Reid-n0rc/open-bt-rig-interface/firmware/README.md

<!--
SPDX-FileCopyrightText: 2026 Reid Crowe, N0RC
SPDX-License-Identifier: PolyForm-Noncommercial-1.0.0
-->

# firmware

Device firmware. `app/` holds portable, host-tested logic (protocol, CAT passthrough, PTT safety, scheduling). `platform/<sdk>/` holds the SDK glue behind a small hardware-abstraction interface. `test/` holds host unit tests. Permissively licensed SDKs and dependencies only. License: PolyForm-Noncommercial-1.0.0 (non-commercial; see COMMERCIAL.md).
