Reid-n0rc/open-bt-rig-interface/THIRD_PARTY.md

<!--
SPDX-FileCopyrightText: 2026 Reid Crowe, N0RC
SPDX-License-Identifier: CC-BY-4.0
-->

# Third-party material and notices

This file is the **single ledger** of material from other projects that is
included in, adapted into, or bundled with this repository and its releases.
Any license that requires a copyright notice, license text or attribution is
satisfied from here.

The repository's own licensing is described in [`LICENSE`](LICENSE) and
[`REUSE.toml`](REUSE.toml). Third-party material **keeps its original license**
and is never relicensed under this project's licenses.

## When an entry is required

Add an entry, in the same PR, whenever you:

- copy or adapt source code, headers or build scripts (firmware, tools, CI);
- copy symbols, footprints or 3D models into `hardware/lib/` (including items
  taken from the KiCad libraries; see below);
- copy text, tables, figures or example circuits from datasheets, application
  notes, reference designs or other projects;
- add a firmware dependency whose code ends up in released binaries
  (SDK components, libraries), even when it isn't committed here;
- ship generated artifacts (fab outputs, STL/3MF, firmware images) that contain
  any of the above.

No entry is needed for facts learned from a source (a pinout, a voltage limit,
a protocol behavior) when nothing is copied. Cite such sources in the relevant
issue, ADR or doc instead.

## Rules

1. **Check the license in the source's actual LICENSE file** (and in file
   headers, which take precedence). Don't rely on a badge, an API summary or
   an earlier issue.
2. **Allowed to copy:** permissive licenses (MIT, BSD-2/3-Clause, ISC,
   Apache-2.0, Zlib, Unlicense/CC0) and CC-BY-4.0 / CC-BY-SA-4.0 for library
   or data files, with their obligations met.
3. **Never copy:** GPL, LGPL, AGPL, "no license", "all rights reserved", or
   terms limited to specific vendors' products (unless this project uses that
   vendor, and the restriction is recorded here). Such sources may be used for
   **facts only**. List them under [Facts only](#facts-only-never-copied).
4. **Keep notices intact:** leave original copyright/license headers in copied
   files, and add the license text to [`LICENSES/`](LICENSES/) under its SPDX
   ID.
5. **REUSE:** give third-party files their real SPDX copyright and license,
   either with file headers or with a path-specific `[[annotations]]` block in
   `REUSE.toml` that takes precedence over the project defaults.
   `uvx --from 'reuse[charset-normalizer]' reuse lint` must pass.
6. **Pin versions:** record the upstream commit or release tag, so the notice
   matches exactly what was used.
7. **Release notices:** every firmware release and every hardware release
   bundle must include a `THIRD_PARTY_NOTICES` file generated from the
   "Currently included" table (full license texts plus copyright lines).

## Entry format

| Field | Content |
|---|---|
| Name | Project or file name |
| Source | URL + pinned commit/tag |
| License | SPDX ID (verified from its LICENSE file) |
| Copyright | Exact copyright line(s) to reproduce |
| Used in | Paths in this repo, or "firmware binary" |
| Modifications | None / summary of changes |
| Obligations | For example "keep notice + license text in source and binary distributions" |
| Added in | PR / issue number |

## Currently included

The files in `LICENSES/` are license texts (taken from SPDX license-list-data)
and aren't third-party works that need an entry. Nothing below is committed to
this repository: the firmware build links it from the pinned SDK and the
pinned ESP Component Registry packages (`main/idf_component.yml`), and the
host tests fetch Unity at build time.

| Name | Source | License | Copyright | Used in | Modifications | Obligations | Added in |
|---|---|---|---|---|---|---|---|
| ESP-IDF | https://github.com/espressif/esp-idf, tag `v6.0.3` (commit `76f5dedd9950a3012fee8fb7d5586df21fc67802`) | Apache-2.0 ([LICENSE](docs/references/index.md#esp-idf-license)) | Copyright (C) 2015-2023 Espressif Systems (as stated in its [COPYRIGHT](docs/references/index.md#esp-idf-copyright) document; file headers take precedence) | Firmware binary (`firmware/platform/esp-idf`): drivers, FreeRTOS port, NVS, esp_timer, bootloader | None | Apache-2.0 text and notices in firmware releases | #14 |
| Components bundled with ESP-IDF v6.0.3 that the image links | As listed in ESP-IDF's [COPYRIGHT](docs/references/index.md#esp-idf-copyright) document | Apache-2.0 (Apache mynewt-nimble; the BLE controller, PHY and coexistence libraries, whose LICENSE files are Apache-2.0), Apache-2.0 OR GPL-2.0-or-later (Mbed TLS / TF-PSA-Crypto: **used under Apache-2.0**), MIT (FreeRTOS kernel, Xtensa headers), BSD (Picolibc/Newlib) | As stated in each component's LICENSE/COPYING file in the ESP-IDF tree | Firmware binary: NimBLE host (the BLE stack), BT controller, PHY and coexistence libraries, FreeRTOS, C library, TF-PSA-Crypto (NimBLE security) | None | Each license text and notice in the release's `THIRD_PARTY_NOTICES` (rule 7). The exact list comes from the linked components of the release build | #14 |
| esp-usb: `espressif/usb` 1.6.0, `usb_host_cdc_acm` 2.4.1, `usb_host_cp210x_vcp` 2.2.0, `usb_host_ftdi_vcp` 2.1.1, `usb_host_ch34x_vcp` 2.2.1 | https://github.com/espressif/esp-usb, from the ESP Component Registry, pinned exactly in `firmware/platform/esp-idf/main/idf_component.yml` (commits `630f1c4e`, `eb0f0216`, `ebfa6f84`, `cb8e2bd4`, `1a7c5aa5`, as each package's `idf_component.yml` records) | Apache-2.0 (each package's LICENSE and file headers; [LICENSE](docs/references/index.md#esp-usb-license)) | Copyright 2015-2026 Espressif Systems (Shanghai) CO LTD (the files' SPDX-FileCopyrightText headers; the years vary per file) | Firmware binary (`firmware/platform/esp-idf`): USB Host Library with hubs, and the CDC-ACM, CP210x, FTDI and CH34x serial drivers for the radio USB port | None (the FTDI RTS/DTR request is sent by this project's code instead of the driver's, see `main/radio_usb.c`) | Apache-2.0 text and notices in firmware releases | #43 |
| Unity | https://github.com/ThrowTheSwitch/Unity, tag `v2.7.0` (commit `b6763fbd9cedfacaa89e2ad9fd00d615a234e355`) | MIT ([LICENSE.txt](docs/references/index.md#unity-license)) | Copyright (c) 2007-26 Mike Karlesky, Mark VanderVoord, & Greg Williams | Host test build only (`firmware/test`, fetched by CMake); never in a firmware image | None | Keep notice + MIT text if it is ever redistributed | #14 |

## Known candidates (not yet included)

Sources already identified for upcoming work. Each license below was read from
the project's LICENSE file on 2026-09-24. **Re-check it when you actually pull
the material in**, and move the row to "Currently included".

| Name | Source | License | Copyright (from LICENSE) | Likely use | Obligations if used |
|---|---|---|---|---|---|
| ft8_lib | https://github.com/kgoba/ft8_lib | MIT | Copyright (c) 2018 Kārlis Goba | Optional on-device FT8/FT4 tone synthesis (#17) | Keep notice + MIT text in source and binaries |
| ESP32_ft8_lib | https://github.com/guido57/ESP32_ft8_lib | MIT | Copyright (c) 2018 Kārlis Goba (as stated in its LICENSE) | Reference/port of ft8_lib to ESP32 (#17) | Same as ft8_lib; also credit the port's author if any of its code is used |
| ESP32_BleSerial | https://github.com/avinabmalla/ESP32_BleSerial | MIT | Copyright (c) 2022 Avinab Malla | BLE-to-UART bridge reference (#15) | Keep notice + MIT text |
| esp32-ble-uart-mx | https://github.com/olegv142/esp32-ble-uart-mx | Unlicense | Public domain dedication | BLE-to-UART reference (#15) | None required; credit as a courtesy |
| ESP-ADF | https://github.com/espressif/esp-adf | "ESPRESSIF MIT License" (not SPDX MIT) | Copyright (c) 2018 Espressif Systems (Shanghai) | Audio framework, only if an Espressif module is selected | The grant covers **use on Espressif products only**; record that restriction here if it's used |
| KiCad libraries | https://gitlab.com/kicad/libraries | CC-BY-SA-4.0 + design exception | KiCad library contributors | Symbols/footprints/3D models | See the KiCad section below |

The other candidate firmware SDKs from the module decision (#7), such as
Infineon's or Microchip's, must be checked against rules 1–3 before selection.
Their license terms are part of the decision.

## KiCad library material

The KiCad libraries are CC-BY-SA-4.0 with an exception: designs that *use* the
library data (schematics, boards and generated fab files) are **not** bound by
it, and need no attribution
([license](https://gitlab.com/kicad/libraries/kicad-symbols/-/blob/master/LICENSE.md)).

However, **copying library items into `hardware/lib/`** redistributes part of
the library, so those copied files stay **CC-BY-SA-4.0**. Therefore:

- keep their attribution;
- give them a `REUSE.toml` annotation with `CC-BY-SA-4.0` and add
  `LICENSES/CC-BY-SA-4.0.txt`;
- list each copied item (or library file) under "Currently included".

Prefer referencing the stock libraries, and only copy an item when it has to
be modified or pinned. Vendor models and footprints from third-party
download sites often carry their own terms. Check them the same way, and
don't commit any that forbid redistribution.

## Facts only (never copied)

Sources consulted for facts, whose licenses don't allow copying into this
repository. Licenses were verified from each LICENSE file on 2026-09-24.

| Name | Source | License | Why listed |
|---|---|---|---|
| Digirig hardware | https://github.com/softcomplex/digirig | GPL-3.0 | Wired-interface reference; no schematics or layout copied |
| Mobilinkd TNC3 firmware | https://github.com/mobilinkd/tnc3-firmware | GPL-3.0 | BLE + audio interface reference |
| arduino-audio-tools | https://github.com/pschatzmann/arduino-audio-tools | GPL-3.0 | Microcontroller audio streaming reference |
| ESP-IDF examples `bluetooth/nimble/bleprph` and `custom_bootloader/bootloader_hooks` (v6.0.3) | [bleprph](docs/references/index.md#esp-idf-nimble-bleprph), [bootloader_hooks](docs/references/index.md#esp-idf-bootloader-hooks-example) | Apache-2.0 (bleprph's header; the hooks example has none and falls under ESP-IDF's Apache-2.0) | Consulted for the NimBLE start-up and bootloader-hook API sequence (#14); the firmware's code was written for this project, nothing copied. Permissive, listed for traceability |
| Linux kernel `drivers/usb/serial/ftdi_sio.h` | https://github.com/torvalds/linux/blob/f2c53ea949c5048f96b3dbb5a5ee7131ce4ff2de/drivers/usb/serial/ftdi_sio.h | GPL-2.0 | FTDI vendor request codes (modem control) checked against esp-usb for #9, and used for FTDI RTS/DTR in #43 (request 1, mask in the high byte); nothing copied |
| Linux kernel (`cdc-acm`, `snd-usb-audio`) | https://github.com/torvalds/linux (v6.16, `038d61fd`) | GPL-2.0 | Host driver behavior for USB CDC-ACM line state and USB Audio Class versions (#6) |
| BlueZ | https://github.com/bluez/bluez (5.87, `65d11ede`) | GPL-2.0 / LGPL-2.1 (`COPYING`, `COPYING.LIB`) | L2CAP LE CoC socket API and GATT D-Bus docs (#6) |
| Linux kernel USB network drivers (`drivers/net/usb/usbnet.c`, `cdc_ncm.c`, commit 038d61fd6422) | https://github.com/torvalds/linux | GPL-2.0 | CDC-NCM host behavior and interface naming (`usbN` / `ethN`) for the protocol's USB network transport (#13); nothing copied |

Add more rows as sources are consulted. Record unlicensed sources here too,
marked "no license".

## Standards and datasheets

Standards (for example ISO 16750-2, ISO 7637-2, CISPR 25), datasheets,
application notes and module integration guides are cited for their
requirements and values in the relevant docs and ADRs. Quoting or reproducing
figures, tables or reference circuits from them requires an entry here and
must comply with the publisher's terms. Many don't allow redistribution, so
summarize and cite instead.
