Reid-n0rc/open-bt-rig-interface/docs/research/power-radio-usbc.md

<!--
SPDX-FileCopyrightText: 2026 Reid Crowe, N0RC
SPDX-License-Identifier: CC-BY-4.0
-->

# Variant R power: radio accessory DC and USB-C (revision A)

Issue: [#11](https://github.com/Reid-n0rc/open-bt-rig-interface/issues/11).
Decision record: [ADR-0005](../decisions/ADR-0005-power-radio-usbc.md).

Scope: the variant R power input, from the radio's accessory DC pin and the
USB-C port to the 3.3 V rail. It covers protection, source selection,
regulation, the switching frequency, the power budget per mode, radio-on sense,
auto power up/down, parts and cost, and the EU EMC targets. Schematic capture
and layout are out of scope, and so is variant M
([#10](https://github.com/Reid-n0rc/open-bt-rig-interface/issues/10)).

Inputs:

- **Radio DC pins and current limits:** the per-radio table from #5
  ([PR #56](https://github.com/Reid-n0rc/open-bt-rig-interface/pull/56),
  `docs/research/radio-interfaces.md`), which cites the manufacturers' manuals
  page by page. This doc repeats only the figures it needs.
- **Module current:** [ESP32-S3-MINI-1 datasheet](../references/index.md#esp32s3-mini1-ds)
  Tables 6-5 to 6-7. BLE TX is capped at the FCC grant's 10.3 dBm
  ([`module-selection.md`](module-selection.md)), so the +9 dBm figure applies.
- **USB-C host power:** #6 ([PR #54](https://github.com/Reid-n0rc/open-bt-rig-interface/pull/54),
  `docs/research/host-compatibility.md` §2.4) and the
  [USB Type-C specification](../references/index.md#usb-typec-r20).
- **Codec rails:** ADR-0002 from #8 ([PR #55](https://github.com/Reid-n0rc/open-bt-rig-interface/pull/55))
  and the [TLV320AIC3104 datasheet](../references/index.md#ti-tlv320aic3104-ds).
- **Host links:** [ADR-0008](../decisions/ADR-0008-host-links-esp32-s3.md)
  (accepted). The issue predates it and has no ADR-0008 scope update, so this
  doc applies it: wired USB-C mode with the on-board hub, and isolation of the
  AUDIO and SERIAL jacks whenever the USB-C data link is used.
- **Variant M:** #10 ([PR #57](https://github.com/Reid-n0rc/open-bt-rig-interface/pull/57),
  ADR-0004) owns the **shared regulator core and the 2.304 MHz clock**. This
  doc uses them and specifies only what is particular to variant R.

Conventions: **(verify)** marks a fact or estimate that a bench test or a
later issue must confirm. `unknown` means no primary source was found.

## Maintainer decisions (2026-09-24)

1. **Power flows in only.** The device takes power from the radio's DC
   accessory pin or USB-C (and, on variant M, 12 V). **It never supplies
   power on any port, with one deliberate exception:** the SERIAL jack's
   ring-2 3.3 V output (about 20 mA, current-limited, off by default). It
   powers circuits inside a cable and never the radio (maintainer decision
   2026-09-25, recorded in ADR-0003, PR #61). Otherwise it doesn't source VBUS to the radio's USB port in
   either host mode, and it is a sink only on USB-C, in wired mode too.
   Hardware blocks current from the device into the radio's VBUS. That circuit,
   and the matching edits to `constraints.md` and `requirements.md`, belong to
   #9 (ADR-0003). Issue item 5 (a VBUS supply to the radio) and the IC-705
   battery-charging case therefore **no longer apply**. The K4 connects only
   through its USB-B port; its rear USB-A ports are not used for power or data.
2. **Optimize for spurious emissions and cost, and share the regulator core
   with variant M:** one **TI LMR43620MC3RPERQ1** buck (MODE/SYNC, no spread
   spectrum, fixed 3.3 V), synchronized in forced PWM to 2.304 MHz, fed
   directly from the OR of the two inputs. There's no 5 V rail. The input
   protection is sized for a station, not a car. Use the cheapest parts that
   meet −20 to +60 °C and the electrical need; AEC-Q isn't required.
3. **EU requirements (#59):** every part must be RoHS-compliant. EU EMC
   (EN 55032 Class B, EN 301 489-1 immunity) is a design target alongside FCC
   Part 15B (§10).

## Summary

- **Radio DC input (11–15 V nominal, 9–17.5 V accepted):** **0.25 A fast
  fuse** (the current limit: it opens within 5 s at 0.5 A, the K3's pin limit)
  → **B5819W Schottky** (reverse polarity, no back-feed into the radio) →
  **SMBJ15A TVS** → the power mux.
- **USB-C:** 5 V sink, 5.1 kΩ Rd on CC1 and CC2, no USB PD. The firmware reads
  CC to learn the host's current advertisement. Every mode fits the **500 mA**
  Default current.
- **Source selection:** one **TI TPS2121** priority power mux, directly on both
  inputs. Radio DC has priority when it is above 9 V; USB-C is the fallback.
  It controls inrush (soft start), cuts off each input on overvoltage
  (17.5 V and 5.8 V) and blocks back-feed into both sources.
- **Regulation:** the mux feeds one **LMR43620MC3RPERQ1** (3.3 V, 2 A),
  synchronized to the shared **2.304 MHz** clock (ADR-0004: an 18.432 MHz
  oscillator divided by 8 in three flip-flops). No harmonic from 160 m to 10 m lands in an
  amateur band (worst margin 85 kHz). The duty cycle stays inside the part's
  limits from 4.4 V to 17.5 V in. The same 2.304 MHz clock feeds the codec,
  whose PLL makes 48 kHz from it (ADR-0002, PR #55). The
  codec gets an **LP5907-3.0** LDO (analog) and a **TPS7A2018** (core, fed
  from the 3.0 V output), as ADR-0002 specifies.
- **Power budget:** 0.5–1.4 W average, 1.6 W peak. **Wired mode draws about
  292 mA from USB-C at 4.75 V (315 mA at 4.4 V)**, about 185 mA under the
  500 mA Default.
- **Radios that can power variant R:** IC-7300, TS-590SG, K3, K3S and K4
  (documented limits, switched outputs). The Yaesu +13 V pins and the TS-590S
  wait for a bench measurement. The IC-705, KX2, KX3, X6100 and
  FT-817ND/FT-818 use USB-C.
- **Radio-on sense:** the switched DC pin; otherwise the radio's USB attach,
  the SERIAL-jack idle level, or a CAT reply. Radio-powered: the device follows
  the radio. Otherwise, **with no USB host attached**, it powers down **30 s
  after radio-on sense goes off** (configurable, 0 = never). It stays awake
  while a USB host is connected (maintainer decisions, 2026-09-25).
- **Power-section BOM:** about **$6.4 at quantity 100** (§9.2), with the buck
  at TI.com's $2.494 (LCSC charges $3.99 and holds only 10).

## 1. Radio DC input

### 1.1 What the radios supply

From #5 (manual page citations there):

| Radio | Pin | Voltage | Documented limit | Switched with radio |
|---|---|---|---|---|
| IC-7300 | ACC pin 8 | 13.8 V | 1 A | Yes |
| TS-590SG | EXT.AT pin 6 "14S" | 13.8 V | 4 A | Yes |
| TS-590S | EXT.AT pin 6 "14S" | 13.8 V | `unknown` | Yes |
| K3 | 12 VDC OUT (RCA) | 13 V no load, **12 V at max load** | **0.5 A** | Yes |
| K3S | 12 VDC OUT (RCA) | 13 V no load, 12 V at max load | 1.0 A | Yes |
| K4 | 12 VDC OUT | 12 V | 1.5 A (self-resetting fuse) | Yes |
| FT-891, FT-991A | TUN/LIN "+13V OUT" | 13 V | `unknown` | `unknown` |
| FT-710 | TUNER/LINEAR pin 1 "+13V" | 13 V | `unknown` | Yes |
| FT-817ND / FT-818 | ACC "+13.8V" | Not stated; radio runs on 8–16 V or battery | `unknown` | `unknown` |

Design limits taken from this table:

- **Current limit below 0.5 A** (the K3, the lowest documented limit).
- **Voltage:** 12 V under load on the Elecraft pins; Icom's supply range of
  13.8 V ± 15 % (up to 15.9 V) passes straight through to the pin.
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
