Reid-n0rc/open-bt-rig-interface/docs/research/audio-codec.md

<!--
SPDX-FileCopyrightText: 2026 Reid Crowe, N0RC
SPDX-License-Identifier: CC-BY-4.0
-->

# Audio codec and isolation transformers

Issue: [#8](https://github.com/Reid-n0rc/open-bt-rig-interface/issues/8).
Researched 2026-09-24. Decision: [ADR-0002](../decisions/ADR-0002-audio-codec.md).

This study covers the **analog radio audio path**: the codec, the AUDIO-jack
isolation transformers, RF hardening at the jack, and the level plan. Radios
with a built-in USB sound card use the USB path instead
([ADR-0008](../decisions/ADR-0008-host-links-esp32-s3.md),
[constraints §8](../requirements/constraints.md#8-audio)).

**Scope adapted to ADR-0008.** The issue text predates ADR-0008 and asks for
compatibility with an HFP audio path. There is no Bluetooth Classic and no HFP.
The codec connects to the **ESP32-S3 over I2S** and serves both host links:
the Bluetooth LE audio stream and the USB Audio Class sound card in wired mode.
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
