Reid-n0rc/open-bt-rig-interface/docs/developer-guide.md

# Developer guide

This is the practical *how-to* for working on open-bt-rig-interface, for people and
AI agents alike. The **rules** live in [`AGENTS.md`](../AGENTS.md) and the short
version in [`CONTRIBUTING.md`](../CONTRIBUTING.md). This guide links to both
rather than repeating them. If this guide and `AGENTS.md` disagree, `AGENTS.md`
wins; please open an issue so the guide gets fixed.

Before any design work, read
[`docs/requirements/constraints.md`](requirements/constraints.md).

## Contents

1. [Prerequisites and setup](#1-prerequisites-and-setup)
2. [Repo tour](#2-repo-tour)
3. [From issue to merged PR](#3-from-issue-to-merged-pr)
4. [Local checks](#4-local-checks)
5. [Recipes by type of work](#5-recipes-by-type-of-work)
6. [Releases and tags](#6-releases-and-tags)
7. [Troubleshooting](#7-troubleshooting)

---

## 1. Prerequisites and setup

| Tool | Why | Notes |
|---|---|---|
| git ≥ 2.34 | Version control, SSH commit signing | Signed commits are preferred, not required (see below) |
| [GitHub CLI `gh`](https://cli.github.com/) | Issues, PRs, checks | `gh auth login` |
| [KiCad](https://www.kicad.org/download/) **≥ 10.0.6** | Schematic/PCB | Must match [`KICAD_VERSION`](../KICAD_VERSION) |
| `kicad-cli` | ERC/DRC and exports from the shell | Ships with KiCad (paths below) |
| [`uv`](https://docs.astral.sh/uv/) | Runs `reuse` without a global install | `uvx --from 'reuse[charset-normalizer]' reuse lint` |
| [Konnect](https://github.com/Reid-n0rc/Konnect) | KiCad MCP server that agents **must** use for KiCad changes | Load the `konnect` skill first (see [`AGENTS.md`](../AGENTS.md#hardware-kicad)) |
| Firmware SDK | Device firmware | **TBD**: chosen by the module decision (#7) and set up in #14 |

### `kicad-cli` location

| OS | Path |
|---|---|
| macOS | `/Applications/KiCad/KiCad.app/Contents/MacOS/kicad-cli` |
| Windows | `C:\Program Files\KiCad\10.0\bin\kicad-cli.exe` |
| Linux | `kicad-cli` on `PATH` (distribution or official PPA/Flatpak package) |

Check the version with `kicad-cli version`. It must be at least the
`KICAD_MIN_VERSION` in [`KICAD_VERSION`](../KICAD_VERSION). CI runs the pinned
`kicad/kicad:<KICAD_MIN_VERSION>` Docker image.

### Signed commits (preferred)

Signed commits (SSH or GPG) are preferred but not required. The branch ruleset
doesn't enforce signatures; PRs are still required for `main` and `dev`. SSH
signing is the simplest option:

```sh
git config --global gpg.format ssh
git config --global user.signingkey ~/.ssh/<your-key>.pub
git config --global commit.gpgsign true
# Let git verify your own signatures locally:
echo "$(git config user.email) $(cat ~/.ssh/<your-key>.pub)" >> ~/.ssh/allowed_signers
git config --global gpg.ssh.allowedSignersFile ~/.ssh/allowed_signers
```

Then add the same public key to GitHub as a **Signing key** (Settings → SSH and
GPG keys → New SSH key → Key type: *Signing Key*). GPG signing works too.

If you have signing set up, keep it on; don't pass `--no-gpg-sign` or
`-c commit.gpgsign=false`. If signing fails, fix the setup or mention it in the
PR rather than silently committing unsigned.

### Private or local tooling

Anything private, credentialed or specific to your machine goes in the untracked
`AGENTS.local.md` or `CLAUDE.local.md` at the repo root (both are gitignored).
Never commit credentials, and never name private tools in tracked files.

---

## 2. Repo tour

| Path | What's there |
|---|---|
| [`hardware/boards/`](../hardware/boards/) | KiCad projects, `hardware/boards/<board>/rev<X>/` |
| [`hardware/lib/`](../hardware/lib/) | Project-local symbols, footprints, 3D models |
| [`hardware/enclosure/`](../hardware/enclosure/) | 3D-printed enclosure CAD source |
| [`firmware/`](../firmware/) | `app/` portable core, `platform/<sdk>/` SDK glue, `test/` host tests |
| [`protocol/`](../protocol/) | Versioned host-device Bluetooth protocol spec and golden vectors |
| [`tools/`](../tools/) | Scripts and checks (KiCad version check, etc.) |
| [`docs/requirements/`](requirements/) | Constraints and requirements |
| [`docs/decisions/`](decisions/) | ADRs, one decision per file |
| [`docs/bringup/`](bringup/), [`docs/compliance/`](compliance/) | Bench bring-up notes, FCC/regulatory material |
| [`LICENSES/`](../LICENSES/), [`REUSE.toml`](../REUSE.toml) | License texts and the path-to-license mapping |

Every directory has a `README.md` explaining its purpose. Read it before adding files there.

**Licensing and governance:** this guide deliberately doesn't restate license
terms. Which license applies to which path, and any commercial-use or
governance terms, are defined in [`LICENSE`](../LICENSE),
[`REUSE.toml`](../REUSE.toml) and [`AGENTS.md`](../AGENTS.md#licensing-reuse),
plus [`COMMERCIAL.md`](../COMMERCIAL.md) and [`GOVERNANCE.md`](../GOVERNANCE.md).

---

## 3. From issue to merged PR

The full rules are in [AGENTS.md → Workflow](../AGENTS.md#workflow). Step by step:

1. **Pick or open an issue.** No change without one. Open issues use the
   templates in `.github/ISSUE_TEMPLATE/`. Issues labeled `human-task` need a
   person (hardware, accounts, a bench) and aren't for agents. The overall
   order of work is tracked in the roadmap issue (#22).
2. **Plan.** Write the plan in the issue (or in the PR description for small
   changes) before editing anything. Check the issue's *Verify first* items.
   If one turns out false, stop and comment on the issue.
3. **Branch from `dev`:**
   ```sh
   git fetch origin
   git switch -c <type>/<issue#>-<slug> origin/dev   # e.g. hw/9-cat-ptt-circuits
   ```
   Types: `hw`, `fw`, `proto`, `docs`, `ci`, `enc`, `research`. Git worktrees
   (`git worktree add ../<repo>-<slug> -b <branch> origin/dev`) keep parallel
   work separate.
4. **Commit** (signed if you can) and check before pushing:
   ```sh
   git log --format='%h %G? %s' origin/dev..HEAD   # G = good signature; N = unsigned (allowed)
   ```
5. **Run the local checks** in [section 4](#4-local-checks).
6. **Push and open the PR against `dev`:**
   ```sh
   git push -u origin <branch>
   gh pr create --base dev --title "…" --body "Closes #<issue>

   …"
   ```
   Fill in the PR template checklist.
7. **Merge.** Required checks must pass, and the ruleset requires a PR (signatures
   are preferred, not enforced). `dev` is the default branch, so `Closes #N` closes the issue when
   the PR merges. Merged branches are deleted automatically.
8. **Releases** go from `dev` to `main` through a release PR ([section 6](#6-releases-and-tags)).

---

## 4. Local checks

Run what applies to your change before pushing. CI runs the same checks:
`.github/workflows/checks.yml` (`REUSE lint`, `KiCad version consistency`,
`Silkscreen revision check`, `Protocol vectors`, `Firmware host tests`,
`Firmware target build (ESP-IDF)`) and `.github/workflows/kicad-checks.yml`
(`KiCad ERC/DRC gate`). They all always report, so they can be required status
checks.

**Licensing (every PR):**
```sh
uvx --from 'reuse[charset-normalizer]' reuse lint
```
Every new file needs SPDX headers or must be covered by
[`REUSE.toml`](../REUSE.toml). Which license a path gets is defined there and in
[AGENTS.md → Licensing](../AGENTS.md#licensing-reuse).

**KiCad version consistency (every PR):**
```sh
python3 tools/kicad_ci/check_kicad_version.py
```
Every `*.kicad_sch`, `*.kicad_pcb`, `*.kicad_sym`, `*.kicad_mod` and
`*.kicad_pro` must carry the format tokens in [`KICAD_VERSION`](../KICAD_VERSION):
`generator_version "10.0"` plus the file's format date (`version`), or
`meta.version` for projects. Footprints use the board format. Docs that quote a
minimum KiCad version ("KiCad ≥ X.Y.Z", "X.Y.Z or newer", `kicad/kicad:X.Y.Z`)
must quote `KICAD_MIN_VERSION`. If you saved files with a newer KiCad, bump
`KICAD_VERSION` (and the docs) in the same PR.

**ERC for schematic changes, DRC for PCB changes (both must pass to merge):**
```sh
kicad-cli sch erc --severity-all --exit-code-violations --format json \
  -o erc.json hardware/boards/<board>/rev<X>/<board>.kicad_sch

kicad-cli pcb drc --schematic-parity --severity-all --exit-code-violations \
  --format json -o drc.json hardware/boards/<board>/rev<X>/<board>.kicad_pcb
```
CI runs the same checks with the scripts in [`tools/kicad_ci/`](../tools/kicad_ci/),
inside the `kicad/kicad` image pinned by `KICAD_VERSION`. Their unit tests:
`python3 -m unittest discover -s tools/kicad_ci -p 'test_*.py'`.

A nonzero exit code means violations. Fix them, or document an intentional
exclusion in the KiCad project (not in CI), and say why in the PR. Agents can run
the same checks through Konnect's review tools.

**Silkscreen revision (hardware PRs):**
```sh
python3 tools/kicad_ci/check_silkscreen.py                    # every board
python3 tools/kicad_ci/check_silkscreen.py --tag hw-R-revA-v1.0  # as on a release tag
```
For each PCB in `hardware/boards/<board>/rev<X>/`: the title-block revision is
`<X>` and the date is set; front silkscreen text uses `${REVISION}` and
`${ISSUE_DATE}` and `${VARIANT}`; no silkscreen text hard-codes a revision; the
silkscreen shows the project name, "Designed by Reid Crowe, N0RC" and "CC
BY-NC-SA 4.0" (project text variables are resolved); and the board declares at
least one KiCad design variant with a tag-safe name. On an
`hw-<variant>-rev<X>-v<semver>` tag, a board in a `rev<X>` folder must declare
the design variant `<variant>` ([ADR-0006](decisions/ADR-0006-variants-and-board-strategy.md)).

**Firmware (host tests, every PR):**
```sh
cmake -S firmware/test -B build/fw-test
cmake --build build/fw-test
ctest --test-dir build/fw-test --output-on-failure
```
Builds [`firmware/app`](../firmware/app/) against a fake HAL with ASan and
UBSan, and runs the PTT, codec (every golden vector), configuration and
session tests. Needs CMake 3.16+, a C11 compiler, Python 3 and git
([`firmware/test/README.md`](../firmware/test/README.md)).

**Firmware (ESP32-S3 build):** install ESP-IDF v6.0.3 (or use the
`espressif/idf:v6.0.3` Docker image), then:
```sh
cd firmware/platform/esp-idf
idf.py set-target esp32s3   # once
idf.py build
idf.py -p <UART port> flash monitor
```
Flash through the ESP32-S3-DevKitM-1's USB-to-UART port; the pin map is in
[`BOARD.md`](../firmware/platform/esp-idf/BOARD.md). CI runs both as
`Firmware host tests` and `Firmware target build (ESP-IDF)`, and uploads the
images as an artifact.

**Protocol:** `python3 -m unittest discover -s tools/protocol -p 'test_*.py'`
and `python3 tools/protocol/make_vectors.py --check`.

---

## 5. Recipes by type of work

### Research or decision issue
1. Answer every question in the issue, with a source for each claim. Check the
   license of any design or code you look at and follow the third-party rules
   in [AGENTS.md → Licensing](../AGENTS.md#licensing-reuse): reuse only
   license-compatible material, keeping its notices and recording it in
   [`THIRD_PARTY.md`](../THIRD_PARTY.md). GPL, LGPL, AGPL and
   unlicensed sources are **facts only, never copied**.
2. Write findings to the path the issue names, and for decisions copy
   [`ADR-0000-template.md`](decisions/ADR-0000-template.md) to
   `docs/decisions/ADR-NNNN-<slug>.md`. Accepted ADRs are never edited; a later
   ADR supersedes them.
3. Update [`constraints.md`](requirements/constraints.md) when a *(verify)*
   value gets confirmed or corrected.
4. For parts: prefer **FCC-certified modules** (record the FCC ID and follow the
   integration guide), with at least two sources and an active lifecycle.
   Record alternates.

### Hardware change (KiCad)
1. **Agents: Konnect only.** Load the `konnect` skill, then the task skill
   (`kicad-schematic`, `kicad-pcb`, `kicad-library`, `kicad-review`,
   `kicad-manufacture`). Never hand-edit `.kicad_*` files.
2. Put new symbols, footprints and 3D models in `hardware/lib/…`, referenced
   through the project library tables with `${KIPRJMOD}`-relative paths. Never
   point at personal global libraries.
3. Keep the silkscreen template intact: project name, variant (`${VARIANT}`), `${REVISION}`,
   `${ISSUE_DATE}`, "Designed by Reid Crowe, N0RC", and the license mark
   required by [AGENTS.md](../AGENTS.md#hardware-kicad).
4. **Variants:** R and M are KiCad design variants of one board
   ([ADR-0006](decisions/ADR-0006-variants-and-board-strategy.md)). Change
   fitting or per-variant values in the schematic with that variant selected,
   then update the PCB from the schematic. Never copy the board to make a variant.
5. **New board revision:** copy `rev<X>` to `rev<X+1>`, update the title-block
   revision and date, and note it in [`CHANGELOG.md`](../CHANGELOG.md).
6. Run ERC and DRC ([section 4](#4-local-checks)). Don't commit fab outputs; CI
   builds them for releases.

### Firmware change
Portable logic goes in `firmware/app/` with host tests in `firmware/test/`, and
SDK glue in `firmware/platform/<sdk>/`. **PTT fail-safes are mandatory**, and
every new code path needs a test ([AGENTS.md → Firmware](../AGENTS.md#firmware)).
The SDK is ESP-IDF v6.0.3 on the ESP32-S3; build, test and flash commands are
in [section 4](#4-local-checks), and the layout in
[`firmware/README.md`](../firmware/README.md). Hardware access goes through
[`hal.h`](../firmware/app/include/hal.h), so new logic lands in `firmware/app`
with a host test and only the glue in `firmware/platform/esp-idf`. Changes to
the PTT controller need the maintainer's explicit approval in the PR.

### Protocol change
Edit the spec in [`protocol/`](../protocol/), bump the protocol version, and
regenerate or extend the golden byte vectors in the same PR. Host apps pin a
`proto-v…` release, so never change a released version in place. Details
arrive with #13.

### Enclosure change
Edit the parametric CAD source in `hardware/enclosure/<variant>/` (`R/` or `M/`; both fit the one board). STL/3MF files
are exported for releases, not committed (#19). Keep the antenna keep-out
area free of metal, and use ASA for the automotive variant.

### Human tasks
`human-task` issues (bench tests, printing, measurements, account actions) are
done by a person. Record the results in the issue and, where relevant, under
`docs/bringup/` or `docs/compliance/` through a normal PR.

---

## 6. Releases and tags

`main` receives releases only, through a `dev` → `main` PR. Tags:

| Artifact | Tag | Example |
|---|---|---|
| Hardware | `hw-<variant>-rev<X>-v<semver>` | `hw-R-revA-v1.0` |
| Firmware | `fw-v<semver>` | `fw-v0.1.0` |
| Protocol | `proto-v<semver>` | `proto-v1.0.0` |

A hardware tag must match the board's title-block revision and folder, and
name a design variant the board declares; each variant is tagged and released
separately (`hw-R-revA-v1.0`, `hw-M-revA-v1.0`), with outputs exported for that
variant only. Release
assets (Gerbers, drill, BOM, pick-and-place, PDFs, STL/3MF, firmware images)
are produced by CI and attached to the GitHub release.

---

## 7. Troubleshooting

| Symptom | Fix |
|---|---|
| Commit shows `N` or `E` in `git log --format='%G?'` | `N`: unsigned, which is allowed, though signing is preferred. `E`: git can't verify it locally because your key isn't in `allowed_signers`. See [section 1](#signed-commits-preferred). |
| Push to `dev` or `main` rejected | Expected. Push a feature branch and open a PR. |
| `uvx reuse lint` fails with an encoding / `charset_normalizer` error | Use `uvx --from 'reuse[charset-normalizer]' reuse lint`. |
| `reuse lint` reports an unused license | A license text in `LICENSES/` must be used by at least one file. Keep `REUSE.toml` and `LICENSES/` in step. |
| `kicad-cli: command not found` | Use the full path from [section 1](#kicad-cli-location), or add KiCad's `bin` to `PATH`. |
| KiCad version check fails after saving | You saved with a different KiCad. Use the version in `KICAD_VERSION`, or bump it in the same PR if the project is moving forward. |
| Issue closed but PR not merged, or the reverse | `Closes #N` only acts on merges into `dev` (the default branch). Check the PR base. |
