Reid-n0rc/open-bt-rig-interface/docs/bringup/README.md

<!--
SPDX-FileCopyrightText: 2026 Reid Crowe, N0RC
SPDX-License-Identifier: CC-BY-4.0
-->

# docs/bringup

Board bring-up procedures and results, per variant and revision.
