Reid-n0rc/open-bt-rig-interface/firmware/platform/esp-idf/main/status_led.h

/*
 * SPDX-FileCopyrightText: 2026 Reid Crowe, N0RC
 * SPDX-License-Identifier: PolyForm-Noncommercial-1.0.0
 */
#ifndef STATUS_LED_H
#define STATUS_LED_H

#include "esp_err.h"

esp_err_t status_led_init(void);

#endif /* STATUS_LED_H */
