Reid-n0rc/open-bt-rig-interface/(commit log)

2026-09-24 Bootstrap repo: agent docs, REUSE licensing, constraints, skeleton
    Add AGENTS.md (workflow, KiCad-via-Konnect, sourcing, silkscreen
    revision, licensing and tag rules) with CLAUDE.md as a pointer; REUSE
    layout with CERN-OHL-P-2.0 (hardware), MIT (firmware/tools/protocol)
    and CC-BY-4.0 (docs); the full design constraints; KICAD_VERSION;
    directory skeleton; ADR template; issue and PR templates.
    Closes #1
2026-09-24 Add revision A roadmap document with dependency graph and merge gates
    Mirrors tracking issue #22 (phases, issue numbers, human-task markers) and
    adds what the checklist can't carry: per-phase exit criteria, a Mermaid
    dependency graph built from each issue's Dependencies section, and the merge
    gates (ERC must pass for schematic changes, DRC for PCB changes, enforced by
    #3's required checks). No checkboxes, so status lives only in #22.
    Closes #23
2026-09-24 Add developer guide: setup, issue-to-PR walkthrough, local checks, recipes
    Practical how-to complementing AGENTS.md (rules) and CONTRIBUTING.md
    (short version): tool setup incl. KiCad >= 10.0.6 and SSH commit signing,
    repo tour, the issue -> branch -> signed PR -> dev flow, local REUSE/KiCad
    version/ERC/DRC checks, recipes per type of work, release tags and
    troubleshooting. License terms are referenced, not restated, so the
    upcoming licensing/governance changes don't need edits here.
    Closes #24
2026-09-24 Expand CONTRIBUTING.md into a full contributor guide
    Adds sections on ways to contribute (templates and labels), picking up work,
    hardware/firmware/protocol/docs expectations, safety and compliance,
    third-party material (THIRD_PARTY.md), AI-assisted contributions, conduct and
    where to find more. The existing intro, workflow list and licensing paragraph
    are left unchanged so the governance, developer-guide and license PRs merge
    cleanly.
    Closes #32
2026-09-24 Add THIRD_PARTY.md ledger for third-party material and notices
    Centralize where material from other projects (code, KiCad library items,
    copied text/figures, bundled firmware dependencies) is recorded with the
    notices its license requires. Point AGENTS.md, CONTRIBUTING.md, README,
    hardware/lib and the PR template at it.
    Closes #31
2026-09-24 CI: required ERC/DRC merge gate for schematic and PCB changes
    ERC runs on the root schematic of every project whose schematics change, and
    DRC (with schematic parity and zone refill) on every project whose PCB
    changes, inside the kicad/kicad image pinned by KICAD_VERSION. The always-run
    "KiCad ERC/DRC gate" job passes when there is nothing to check, so it can be
    a required status check. Selection and running live in tools/kicad_ci with
    unit tests that run in CI.
    Closes #26
2026-09-24 docs: core device shortlist for revision A (#42)
    Candidate key parts per block (radio module, codec, isolation, CAT/PTT,
    USB host, power R/M), with the radio-module candidates checked against
    the hard constraints and open items mapped to the block issues.
2026-09-24 docs: BLE-only design on ESP32-S3-MINI-1, radio connectors, reference library (#42)
    - ADR-0008 (proposed): Bluetooth LE-only host link on the ESP32-S3-MINI-1,
    with both analog radio audio and the radio's built-in USB sound card
    (USB host via espressif/esp-usb). Constraints and README updated.
    - Core device shortlist reworked around the ESP32-S3-MINI-1, with a
    modules-only BLE table (LCSC price/stock, 2026-09-24) and the record of
    why dual-mode Classic was dropped.
    - Radio connector spec: AUDIO and SERIAL 3.5 mm TRRS jacks with a
    cable-compatible pinout and firmware-selected serial modes, plus a
    USB-A host port.
    - Reference library: tracked manifest + generated index, tools/refs/r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
2026-09-24 docs: add wired USB-C host link and common radio side to ADR-0008 (#42)
    - ADR-0008 renamed and extended: Bluetooth LE and wired USB-C host links,
    identical radio-side support in both. In wired mode a 2-port hub and two
    USB switches let the computer reach the radio's own USB-serial chip and
    sound card, plus the device's own sound card and serial ports.
    - Isolation of the jacks is mandatory whenever USB-C data is used; optional
    ADuM4160 isolator on the radio USB port.
    - SERIAL-jack modes are RS-232 tolerant: TMUX6219 switches and a
    single-channel RS-232 transceiver (TRS3221E); RS-232 RTS/DTR outputs
    dropped because the cable-compatible jack has no contacts for them.
    - USB-C 500 mA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
2026-09-24 docs: PCB fabrication and passive-component constraints (#49)
    JLCPCB standard-process board and design rules, 2- vs 4-layer criteria,
    assembly (Basic parts, top side), resistor sizing/derating and MLCC
    selection with the 2x DC voltage rule and DC-bias check.
2026-09-24 docs: cite JLCPCB sources through the reference manifest (#49)
    Adds JLCPCB PCB capabilities, impedance stackup, and PCBA FAQ/price pages
    to docs/references/manifest.json and links pcb-fabrication.md to their
    index entries instead of external URLs.
2026-09-24 docs: requirements specification (#4)
    Numbered REQ-<area>-NNN requirements derived from constraints.md,
    ADR-0008, radio-connectors.md and pcb-fabrication.md, with verification
    methods, status, traceability to issues and a coverage checklist.
2026-09-24 ci: REUSE lint, KiCad version and silkscreen revision checks (#3)
    Add .github/workflows/checks.yml with three always-reporting jobs:
    REUSE lint, KiCad version consistency and Silkscreen revision check.
    - tools/kicad_ci/check_kicad_version.py: every *.kicad_sch/pcb/sym/mod/pro
    and every doc quoting the minimum KiCad version must match KICAD_VERSION.
    KICAD_VERSION gains KICAD_SYM_FORMAT (symbol libraries have their own
    format; footprints use the board format), confirmed with kicad-cli 10.0.6.
    - tools/kicad_ci/check_silkscreen.py: title-block revision vs rev<X> folder,
    ${REVISION}/${ISSUE_DATE} on the front silkscreen, no hard-coded revision,
    required markings, and hw-* tags matching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
2026-09-24 docs: confirm the ESP32-S3-MINI-1 module and add FCC integration notes (#7)
    - docs/research/module-selection.md: FCC grant review of 2AC7Z-ESPS3MINI1
    (single modular, DTS, BLE certified at 0.0107 W conducted, 20 cm mobile
    use), ISED 21098-ESPS3MINI1, SH6MDBT50Q for the fallback, Espressif's
    longevity commitment, dated LCSC price and stock, and risks. The findings
    support ADR-0008; Digi-Key and Mouser couldn't be read and are left blank.
    - docs/compliance/fcc.md: antenna placement and keep-out, enclosure
    clearance, BLE TX power cap, power/reset, USB and strapping-pin rules, host
    label text, user manual statements and a Part 15B SDoC checklist.
    - Reference manifest: grant, ISED cer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
2026-09-24 docs: five-OS host compatibility research for wired USB-C and BLE (#6)
    Adds docs/research/host-compatibility.md: driverless USB CDC-ACM and
    RTS/DTR, UAC1 vs UAC2, OS voice processing and USB-C port power per OS;
    Bluetooth LE PHY, DLE, MTU, connection intervals, L2CAP CoC vs GATT,
    throughput budget and background behavior; LE Audio status. Recommends
    UAC1 for #44 and NimBLE with L2CAP CoC plus a GATT fallback. Sources are
    added to the reference manifest; Linux and BlueZ are listed as facts only.
2026-09-24 docs: audio codec and isolation transformer study, ADR-0002 (#8)
    Compare six codec options and three isolation transformers against the
    constraints, adapted to ADR-0008 (I2S to the ESP32-S3, no HFP). Propose
    the TLV320AIC3104 (alternates TAC5112, TLV320AIC3204) and the Bourns
    SM-LP-5001, with the ESP32-S3 clocking plan, level plan and RF hardening.
    Add the cited datasheets to the reference manifest.
2026-09-24 docs: record -N8, 2-layer and ADR-0008 acceptance decisions (#7)
    Maintainer decisions: revision A uses ESP32-S3-MINI-1-N8, the Espressif
    FCC ID is trusted without further grant checks, 2 layers are acceptable
    for the module, and ADR-0008 is accepted.
2026-09-24 docs: per-radio power and interface table (#5)
    Add docs/research/radio-interfaces.md: DC outputs and current limits, USB
    port/chip/audio, CAT levels, PTT and audio levels for 13 HF/multiband
    radios plus generic interfaces, cited from manufacturer manuals, with
    cable mappings to the AUDIO and SERIAL jacks and a needs-measurement list.
    Add the manuals to the reference library (new `manual` kind) and link the
    findings from constraints.md and radio-connectors.md.
2026-09-24 docs: apply maintainer decisions to ADR-0002 (#8)
    Variant M uses the catalog TLV320AIC3104 (-Q1 noted only as an option).
    Variant R fits 0 ohm bypass resistors with the transformers DNP by
    default; flag the conflict with constraints section 6 in wired mode as an
    open question. Digi-Key and Mouser lookups are deferred by the maintainer,
    not a blocker.
2026-09-24 docs: variant M automotive power front end and ADR-0004 (#10)
    Confirm the ISO 16750-2:2023 and ISO 7637-2:2011 12 V test levels from
    reproducing app notes and the official ISO previews (jump start is now
    26 V). Design the variant M front end: LM74800-Q1 common-source
    load-dump cut-off with a 150 V FET and a TVS stack that absorbs no
    load-dump energy, CMC + pi filter sized against CISPR 25 class 5, two
    LMR43620-Q1 bucks synchronized at 2.304 MHz so no harmonic lands in a
    US HF amateur band, brownout detector forcing PTT off, hold-up and
    off-state drain calculations, dated LCSC/TI prices and stock.
    Update constraints.md 3.2/3.4 and pcb-fabrication.md 6.3 to match, and
    add the cited documents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
2026-09-24 proto: protocol spec 0.1.0, architecture, golden vectors, ADR-0007 (#13)
    - protocol/SPEC.md: one COBS-framed, CRC-16 message stream over BLE GATT,
    L2CAP CoC, TCP over a wired USB network interface (CDC-NCM) and the
    CDC-ACM control port; capability TLVs; CAT with credit flow control;
    PTT keepalive, max TX, RTS/DTR arming; BLE audio framing; clock sync;
    optional tone-sequence TX; capped BLE TX power; new GATT UUIDs.
    - protocol/vectors/: golden vectors for every message, framing and GATT.
    - tools/protocol/: MIT reference codec, vector generator and tests; new
    "Protocol vectors" CI job.
    - docs/architecture.md and ADR-0007 (proposed), including the ESP32-S3
    USB endpoint budget and per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
2026-09-24 docs: jump start is 26 V in REQ-PWR-014 (#10)
    ISO 16750-2:2023 raised the 12 V jump-start level from 24 V to 26 V.
2026-09-24 docs: MC buck variants, thermal limit, stock as data (#10)
    Apply maintainer decisions of 2026-09-24 on PR #57: use the
    LMR43620MC5RPERQ1 / MC3RPERQ1 (MODE/SYNC, no spread spectrum) with the
    MSC variants as alternates, and check the fixed 2.2 MHz pre-sync
    interval against the harmonic table. Record stock levels as data only,
    not as a risk. Add the 150 C TJ limit and typical-load thermal
    estimates, including BLE TX capped at the FCC-grant 10.3 dBm.
2026-09-24 proto: apply maintainer answers on #58 (#13)
    - All defaults configurable with documented ranges; new config keys
    SERIAL_DEFAULT, USB_NET_SUBNET and PAIRING_WINDOW_S; WIRED_PROFILE
    default network; "(maintainer)" markers removed.
    - BLE pairing window: PAIRING capability TLV, feature bit 17, Info flags
    bit 1, STATUS flags bit 6; no protocol message opens it. REQ-HOST-014.
    - Hardware PTT watchdog backstop: PTT TLV hw_max_tx_s, MAX_TX_S limited
    to it, PTT_STATUS reason 12 HW_WATCHDOG. REQ-PTT-007, new REQ-PTT-011.
    - ADR-0007 records the accepted wired function sets, the wired-iOS no-CAT
    limitation and the supersession of ADR-0008's wired function list.
    - Golden vectors regenerated and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
2026-09-24 proto: WIRED_PROFILE default serial; only a local action opens pairing (#13)
2026-09-24 docs: codec clock from 2.304 MHz sync, LDO supplies, RoHS (#8)
    Clock the TLV320AIC3104 from the 2.304 MHz buck-sync oscillator (PLL
    P=3, R=8, J=16, D=0, checked against the datasheet limits) instead of a
    16 MHz MCLK from the ESP32-S3, which stays as the fallback. Supply the
    codec from an LP5907 3.0 V LDO and a cascaded TPS7A2018 1.8 V LDO, with
    the cost of each option. Record RoHS/REACH status and point jack ESD and
    immunity levels to EN 301 489-1 (#59).
2026-09-25 docs: variant R power from radio DC or USB-C, ADR-0005 (#11)
    Input-only power: fuse, Schottky and TVS on the radio DC input, a TPS2121
    priority mux with USB-C (sink only, no VBUS to the radio), and one
    LMR43620MC3RPERQ1 3.3 V buck synchronized to 2.304 MHz, with the HF-band
    harmonic analysis. Adds a per-mode power budget, a table of radios that can
    power variant R, radio-on sense and auto power up/down, dated LCSC prices
    with RoHS status, a BOM cost, and EU EMC targets.
2026-09-25 docs: single-stage 3.3 V buck, cost pass, shared clock, EU (#10)
    Apply maintainer direction of 2026-09-24 on PR #57:
    - One LMR43620MC3RPERQ1 from the protected input to 3.3 V at 2.304 MHz;
    no 5 V rail. Redo on-time (sync to 19.1 V), dropout (sync from 4.2 V,
    regulated to 3.5 V), efficiency, thermal, inductor/output caps, input
    filter, hold-up; keep the 7.0 V PTT-off threshold.
    - Cost pass: AEC-Q kept only in the input protection chain; commercial
    fuse, FETs, CMC, capacitors, supervisor; 18.432 MHz oscillator / 8.
    Power-section main parts about $23.56 -> $10.95 (LCSC, qty 100).
    - Clock shared with the codec MCLK (ADR-0002): accuracy, jitter, levels,
    fanout; LP5907-3.0 codec rail h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
2026-09-25 docs: shared 2.304 MHz clock recommendation (#10)
    Compare a direct 2.304 MHz MEMS oscillator with an 18.432 MHz XO / 8
    (codec via PLL, or codec on 18.432 MHz without PLL) on cost, accuracy,
    jitter, drive and spurious emissions (18.432 MHz vs 17 m, 147.456 MHz in
    2 m). Recommend one 2.304 MHz net from an 18.432 MHz XO and three
    SN74LVC1G80, codec via its PLL, for ADR-0002, ADR-0004 and ADR-0005.
2026-09-25 docs: align variant R clock with ADR-0004 (#11)
    Cite ADR-0004 as the owner of the shared regulator core and the 2.304 MHz
    clock (18.432 MHz oscillator divided by 8 in three SN74LVC1G80, star-fed
    through 33 ohm resistors to the buck, the codec PLL and the isolated
    supply). Drop the SN74HC161 divider, correct the codec MCLK statement,
    update the BOM, and match the shared manifest entries to PR #57.
2026-09-25 docs: radio interface circuits and ADR-0003 (#9)
    SERIAL-jack mode switching (MAX14778, TRS3221E, CI-V), fail-safe PTT with a
    supervisor, window watchdog and hardware 600 s PTT timer, RTS/DTR mapping,
    isolation from 3.3 V with a band-clean 2.304 MHz push-pull supply, clock
    audit, USB routing, esp-usb driver support and per-radio cables, with dated
    LCSC sourcing and RoHS status.
    Records the maintainer decision that the device never powers a radio via
    USB: radio VBUS connects to no device rail. Updates constraints §3.1, §3.4,
    §6 and §7, radio-connectors, withdraws REQ-RIF-007 and adds REQ-RIF-011 and
    REQ-PTT-011.
2026-09-25 docs: auto power-down 30 s after radio-on sense goes off (#11)
    Record the maintainer decision (2026-09-25): configurable, default 30 s.
2026-09-25 proto: POWER_DOWN_DELAY_S config key and REQ-PWR-018 (#13)
2026-09-25 docs: keep LMR43620MC3-Q1, 30 s auto power-down (#10)
    Maintainer follow-ups of 2026-09-25: cheaper buck drop-ins must be
    automotive-grade. The only AEC-Q100 1 A drop-in (LMR43610MSC3RPERQ1) has
    spread spectrum and costs more, so LMR43620MC3RPERQ1 stays for both
    variants; the commercial LMR43610MB3RPER is not adopted. Record the
    30 s configurable auto power-down.
2026-09-25 docs: EU compliance research and ADR-0009 (#59)
    EU conformity becomes a design requirement for every variant.
    docs/compliance/eu.md covers RED (EN 300 328, EN 301 489, safety and
    RF exposure, cybersecurity under Delegated Regulation 2022/30 and its
    repeal), the Cyber Resilience Act, RoHS, REACH Art. 33, WEEE, GPSR,
    the EU economic operator, UN R10 for variant M, the common charger,
    the conformity route, markings and who holds manufacturer obligations.
    constraints.md section 4 and REQ-REG/REQ-EMC entries updated; 32
    references added through the manifest.
2026-09-25 docs: #61 follow-ups: VBUS test options, 640 s timer, watchdog, ADuM4160 at 3.3 V (#9)
    - Radio VBUS stays blocked as fitted by default; DNP test footprints for a
    sense-only feed and 0 Ω bypasses from 3.3 V or USB-C VBUS, with CP2105
    and CH342 VBUS thresholds and a bench-test plan. REQ-RIF-011 reworded.
    - Hardware PTT timer: recommended 640 s nominal (84.5 k || 196 k), minimum
    about 607 s, above the 600 s firmware maximum. ADR-0003 explains why the
    ESP32-S3 internal watchdog can't replace it.
    - TPS3430 window watchdog: recommended drop, with a DNP footprint; what it
    uniquely covers is documented.
    - ADuM4160: purpose stated; runs from 3.3 V on both sides (VBUSx tied to
    VDDx), side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
2026-09-25 docs: ADR-0006 one board with KiCad 10 design variants R and M (#12)
    Revision A is one board, hardware/boards/interface/revA/, built as KiCad 10
    design variants R and M (power input chain and isolation fitting differ; the
    core is identical). Tags hw-R-revA-v1.0 / hw-M-revA-v1.0, outputs exported
    with --variant, ${VARIANT} on the front silkscreen, enclosures R/ (PETG) and
    M/ (ASA).
    check_silkscreen.py now requires declared, tag-safe design variants and
    ${VARIANT} on F.SilkS, and matches hw-* tags to a declared variant instead of
    the board folder name. KiCad 10 manuals and release notes added to the
    reference manifest. AGENTS.md, README, roadmap, developer guide, constraints
    section 13 and th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
2026-09-25 docs: stay awake with a USB host; power-down delay 0 = never (#11)
    Maintainer decisions (2026-09-25): the 30 s auto power-down after radio-on
    sense goes off runs only with no USB host attached, and 0 disables it.
2026-09-25 docs: power-down 0 = never, stay awake on USB host, internal watchdog (#10)
    Maintainer answers of 2026-09-25: the power-down delay may be 0 (never,
    exceeding the off-state target by the user's choice); the device stays
    awake while a USB host is connected; lock-up protection is the ESP32-S3
    internal watchdog, with no external PTT timer. The TPS3710 brownout
    PTT-off stays.
2026-09-25 proto: max TX 300 s with no upper bound, watchdog reset reason, power-down rules (#13)
2026-09-25 proto: user may disable the max-TX timer; align AGENTS, CONTRIBUTING, constraints (#13)
2026-09-25 docs: #61 maintainer decisions: internal watchdogs, no external PTT timer (#9)
    - Remove the TPL5111 PTT timer and the TPS3430 window watchdog (no DNP
    footprints). Lock-up protection is the ESP32-S3's internal watchdogs; a
    reset leaves PTT_REQ at its pulled-off default. The PTT gate is now a
    2-input AND (PTT_REQ, supervisor RESET).
    - Keep the TPS3839G33 brownout supervisor: the ESP32-S3 brown-out detector's
    levels are approximate, it is firmware-enabled, and nothing specifies a
    driving GPIO below the chip's operating range.
    - Max TX is a firmware setting (default 5 min, no upper limit). constraints
    §6 drops the hardware backstop; REQ-PTT-011 rewritten.
    - ADR-0003 records the deci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
2026-09-25 proto: security to CRA level (wired-host approval, trust list, factory reset) (#13)
2026-09-25 docs: ADR-0006 closes the ring-2 3.3 V output question (kept) (#12)
2026-09-25 docs: keep SERIAL ring-2 3.3 V output as the input-only exception (#11)
    Maintainer decision (2026-09-25, ADR-0003): the current-limited, off-by-
    default ring-2 output powers cable-side circuits, never the radio. Name it
    as the one exception and count its 20 mA in every budget mode.
2026-09-25 docs: keep SERIAL ring-2 3.3 V output as a cable-power exception (#9)
    Maintainer decision: keep "3.3 V logic + power" mode. Ring 2 gets about
    3.2 V, limited to about 22 mA by a BC857BS two-transistor limiter, through
    a BAT54 and an AQY212EHAX PhotoMOS that is off unless the mode is selected
    (about $1.10). Recorded in ADR-0003 as a deliberate exception to "the device
    only takes power in": it powers cable-side circuits, never the radio.
2026-09-25 docs: keep the automotive-grade buck; BOM at TI price (#11)
    Buck grade settled in PR #57 (2026-09-25): LMR43620MC3RPERQ1 stays; the
    commercial MB5/MB3 parts aren't adopted. BOM uses TI.com's $2.494 (about
    $6.4 total), with LCSC's $3.99 noted (about $7.9).
2026-09-25 proto: plain USB ports open, WIRED_PORT_LOCK setting (#13)
2026-09-25 docs: radio-port USB switch disconnect for WIRED_PORT_LOCK level 3 (#9)
    The TS3USB221A OE=H state disconnects both paths (datasheet Table 7-1).
    S1 (radio port) is ESP32 GPIO-controlled, powers up connected to hub port 1,
    and firmware drives OE high for WIRED_PORT_LOCK level 3 (protocol PR #58
    §6.1). S2 powers up disconnected.
2026-09-25 fw: portable core, PTT controller, protocol codec and host tests (#14)
    firmware/app (portable C11, no SDK includes): the protocol codec for every
    SPEC 0.1.0 message, config key, CAPS TLV and trust record; the PTT
    controller implementing SPEC §8 (keepalive, RTS/DTR arming, max TX with
    lockout and 0 = off, every PTT-off reason incl. WATCHDOG, config changes
    that never assert PTT, WIRED_PORT_LOCK); configuration with the SPEC
    defaults and ranges and a checked storage format; sessions and dispatch;
    the BLE TX power cap; hooks for CAT, clock sync, audio, the pairing window
    and the #64 security stores (fail closed).
    firmware/test: CMake + Unity v2.7.0 host build against a fake HAL with
    ASan/UBSa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
    [app.c, app.h, ble_power.c, cfg.c, cfg.h, fake_hal.c, fake_hal.h, fake_security.c]
2026-09-25 fw: ESP-IDF v6.0.3 platform for the ESP32-S3-DevKitM-1 (#14)
    The HAL on GPIO, UART, I2S, esp_timer and NVS; NimBLE with the SPEC GATT
    service (bonded, encrypted RX/TX; Info readable), bonds only in the pairing
    window; one BLE TX power cap of +6 dBm for all markets with static
    assertions; a second-stage bootloader hook that drives the PTT pin low;
    the task, interrupt and boot watchdogs locked on (the build fails if they
    are changed) and the reset reason reported as WATCHDOG; the status LED;
    the firmware version from fw-v* tags. Pin map in BOARD.md.
    [ble.c, ble.h, board_pins.h, hal_esp.c, hal_esp.h, main.c, status_led.c, status_led.h]
2026-09-28 proto, fw: SPEC §8.3 radio-port RTS/DTR wording approved; tests (#14)
    Radio ports 1-4 default to pass-through (action 2), which forwards RTS/DTR
    to the radio's own USB-serial chip and doesn't key the AUDIO-jack closure;
    action 1 on a radio port keys the device's own PTT outputs. Pass-through
    lines still count toward the keepalive, max TX and session end. Recorded
    in ADR-0007 (maintainer approval, 2026-09-28). Tests for both defaults and
    action 1 on a radio port.
2026-09-28 proto, fw: SPEC §8.2/§8.4 keepalive scope and native port close approved (#14)
    The keepalive timeout releases only protocol-driven sources, not native
    wired CDC-ACM RTS/DTR; on a native wired port RTS and DTR dropping together
    is a port close (PORT_CLOSED, lines BLOCKED until re-armed). Recorded in
    ADR-0007 (maintainer approval, 2026-09-28); tests extended for both.
2026-10-09 hw: root schematic with empty block sheets per ADR-0006 (#21)
    Created through Konnect: module, usb, audio, serial_ptt, isolation,
    core_clock, power_in_R and power_in_M as empty hierarchical sheets.
    [audio.kicad_sch, core_clock.kicad_sch, interface.kicad_sch, isolation.kicad_sch, module.kicad_sch, power_in_M.kicad_sch, power_in_R.kicad_sch, serial_ptt.kicad_sch]
2026-10-09 hw: board setup, JLCPCB 2-layer rules, net classes and silkscreen block (#21)
    Through Konnect: rules from pcb-fabrication.md §3 (0.15/0.15 mm, 0.3/0.6 mm
    via, 0.5 mm hole to hole); net classes Default, Power and HV_M_Input
    (0.5 mm clearance for the >50 V variant M input); a 66 x 66 mm placeholder
    outline; front silkscreen with the project name, ${VARIANT}, ${REVISION},
    ${ISSUE_DATE}, designer credit and license mark; FCC ID spot on F.Fab.
    [interface.kicad_pcb]
2026-10-09 hw: project-local library tables pointing at hardware/lib (#21)
    ${KIPRJMOD}-relative entries for the open-bt-rig-interface symbol and
    footprint libraries, registered through Konnect.
2026-10-09 fw: CAT bridge queues, credit on drain and radio-side batching (#15)
    Host -> radio: CAT_DATA fills a per-port queue within the host's credit,
    cat_pump() hands it to the HAL as it accepts bytes, and CAT_CREDIT returns
    only what left (SPEC §7.4). Before, bytes the HAL didn't take at once were
    dropped as OVERFLOW even inside the credit.
    Radio -> host: bytes are batched per port and sent when a frame is full or
    2 ms after the first byte (§7.3); a full buffer drops the newest bytes and
    counts them in STATUS.cat_overflows.
    Closing or reopening a port and ending the session discard both queues
    (§7.2). app_next_deadline_us() tells the platform when to wake.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
    [app.c, app.h]
2026-10-09 fw(esp-idf): 1 kHz tick, wake at the CAT deadline, write via the UART ring buffer (#15)
    - hal_serial_write uses uart_write_bytes up to the driver's free TX space
    instead of the 128-byte hardware FIFO, and never blocks.
    - CONFIG_FREERTOS_HZ=1000: at the default 100 Hz the 2 ms UART read
    timeout was 0 ticks, so the RX task polled without blocking.
    - The app task waits until app_next_deadline_us() (at most 10 ms).
    Claude-Session: https://claude.ai/code/session_014tuoCsMufi1hwXtnu3s71d
2026-10-09 tools: dev-kit CAT loopback test over BLE, with simulated-device tests (#15)
    cat_loopback.py starts a session, opens port 0, sends random bytes as
    CAT_DATA within the device's credit and checks they come back byte-exact
    through a TX->RX jumper. The protocol logic is transport-independent and
    tested against a simulated device in CI (Protocol vectors job); only the
    BLE link needs bleak and hardware.
    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
2026-10-09 fw(esp-idf): closing port 0 discards the UART TX ring buffer (#15)
    hal_serial_close only flushed RX, so up to 1 KB the host had queued (for
    example a CAT TX command) still reached the radio after the session ended,
    against SPEC §7.2. Closing now deletes the UART driver, which discards both
    ring buffers; opening installs it again. A mutex keeps the RX task out of
    the driver while it is installed or deleted.
    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
2026-10-28 fw: radio USB port interface selection, ports 1-4 attach/detach (#43)
    usb_radio picks the serial interfaces (CP210x, FTDI, CH34x by VID;
    CDC-ACM by class) of each device on the radio USB port and assigns
    ports 1-4 in interface-number order; it notes sound cards and unusable
    devices for STATUS.flags bits 0-2.
    app_radio_usb_attached/detached add and remove the CAT ports, resend
    CAPS (RADIO_USB_SERIAL TLVs) and STATUS with token 0. Detach closes the
    port: PTT from it (action 1 or pass-through) drops with PORT_CLOSED and
    both queues are discarded; a re-enumerated port starts closed and
    BLOCKED. Wired mode removes the ports. CAPS tx_buffer now reports the
    credit actually granted (cat_initial_cre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
2026-10-28 fw(esp-idf): radio USB host with esp-usb serial drivers (#43)
    The ESP32-S3 USB port is USB host to the radio in Bluetooth mode
    (esp-usb, hubs on). A host client opens each new device, reads its
    descriptors and posts them to the app task; DEV_GONE posts a detach.
    Ports 1-4 are opened by a worker task with the CP210x, FTDI, CH34x or
    CDC-ACM driver (CDC-ACM by USB address), so esp-usb's 5 s control
    transfer timeout never runs on the app task; an open waits at most
    300 ms. RTS/DTR are inactive on open and on close; writes go through a
    512-byte stream buffer per port.
    FTDI RTS/DTR are sent as request 1 with the mask in the high byte (as
    Linux's ftdi_sio.h defines modem control, facts only): esp-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
2026-10-29 hw: save revision A in the KiCad 10 formats with KiCad 10.0.7 (#21)
    Konnect writes KiCad 9 formats and has no project save, so, as the
    maintainer decided for this PR, KiCad 10.0.7 saved the files itself
    (the kicad/kicad:10.0.7 image; no hand edits):
    - the nine schematics and the board: kicad-cli sch/pcb upgrade;
    - the project file (meta version 1 -> 3): pcbnew.SaveBoard, which writes
    the project settings with the board. Design rules and the Default,
    Power and HV_M_Input net classes are unchanged.
    ERC: 0 violations. DRC with schematic parity: 0 violations, 0
    unconnected, 0 parity issues.
    KICAD_VERSION and the docs that quote it move to 10.0.7 (AGENTS.md: a
    newer KiCad bumps it in the sa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
